txr-academy/FlashPod/README.md

# FlashPod
   
   ## Demo Video

https://github.com/user-attachments/assets/2fd0d5ae-2d88-44ac-92bb-8459e2031c8f
