txr-academy/FlashPod/flashpod_product_backlog.xlsx

Sheet: Product Backlog
Story ID | Epic | User Story / Task | Description | Priority | Story Points | Status | Sprint | Component | Acceptance Criteria
EPIC: Hardware Setup
HW-01 | Hardware Setup | Initialize WS2812B LED strip on nRF | Set up SPI1 peripheral on nRF52840 to drive WS2812B 16-pixel LED strip. Configure MOSI pin 17, SCK pin 31. Write rgb_led.c driver. | High | 5 | Done | 1 | nRF / LED | LED strip lights up correct colour when rgb_led_set_all() called
HW-02 | Hardware Setup | Initialize IR sensor on nRF (Pod 1) | Configure GPIO pin 13 as active-low input with pull-up for IR proximity sensor. Write ir_sensor.c driver. | High | 3 | Done | 1 | nRF / IR | ir_sensor_detected() returns true when hand is close
HW-03 | Hardware Setup | Initialize WS2812B LED strip on ESP32 | Use Adafruit NeoPixel library on GPIO pin 17 to drive 16-pixel strip on each ESP32 pod. | High | 3 | Done | 1 | ESP32 / LED | ledSetAll(r,g,b) lights all pixels in correct colour
HW-04 | Hardware Setup | Initialize IR sensor on ESP32 | Configure GPIO pin 13 as INPUT_PULLUP on ESP32. Read pin LOW as hand detected. | High | 2 | Done | 1 | ESP32 / IR | digitalRead(IR_PIN)==LOW triggers detection
HW-05 | Hardware Setup | Configure GPIO mode button on nRF | Connect push button to GPIO pin 24. Configure as active-low input with pull-up. Set up interrupt on falling edge. | Medium | 3 | Done | 2 | nRF / GPIO | button_pressed ISR fires on each button press
EPIC: BLE Communication
BLE-01 | BLE Communication | Set up NUS service on nRF (peripheral to phone) | Register Nordic UART Service. Implement received_from_phone callback for incoming commands. Implement notif_enabled_cb. | High | 5 | Done | 1 | nRF / BLE | Phone can connect and exchange text via nRF Connect app
BLE-02 | BLE Communication | Set up NUS service on ESP32 (peripheral to nRF) | Create BLE server with NUS service UUID. Implement RxCallbacks for commands from nRF. TX characteristic notifies nRF with results. | High | 5 | Done | 1 | ESP32 / BLE | nRF can write commands and receive notifications from ESP32
BLE-03 | BLE Communication | Implement BLE dual-role on nRF | nRF acts as peripheral to phone and central to ESP32 pods simultaneously. Tune scan interval (800ms/50ms window) so phone can connect during scan gaps. | High | 8 | Done | 1 | nRF / BLE | Phone connects while nRF scans for ESP32 pods without drops
BLE-04 | BLE Communication | Implement GATT discovery on nRF central | After connecting to each ESP32, discover all characteristics. Find and store RX handle and TX CCC handle for each pod. | High | 5 | Done | 1 | nRF / BLE | rx_handle and tx_ccc_handle populated after discovery
BLE-05 | BLE Communication | Subscribe to ESP32 notifications on nRF | After GATT discovery subscribe to TX characteristic notifications on each ESP32 pod. Implement pod_notify_cb to handle incoming results. | High | 5 | Done | 1 | nRF / BLE | pod_notify_cb fires when ESP32 sends RT or TIMEOUT
BLE-06 | BLE Communication | Implement write commands from nRF to ESP32 | Use bt_gatt_write_without_response to send ON:RRGGBB, OFF, and TIMEOUT:ms commands to ESP32 pods via RX characteristic handle. | High | 3 | Done | 1 | nRF / BLE | ESP32 LED turns on/off correctly on command
BLE-07 | BLE Communication | Auto-reconnect ESP32 pods on disconnect | Restart BLE scan when any ESP32 pod disconnects. Clear pod state and rediscover handles on reconnect. | Medium | 3 | Done | 2 | nRF / BLE | nRF reconnects to pod automatically after disconnect
BLE-08 | BLE Communication | Restart advertising after phone disconnect | Use adv_sem semaphore to restart BLE advertising from main thread when phone disconnects. | Medium | 2 | Done | 2 | nRF / BLE | Blazepod1 reappears in phone scan after disconnect
EPIC: Game Logic
GAME-01 | Game Logic | Implement IR polling thread on nRF (Pod 1) | Create dedicated Zephyr thread that polls IR sensor every 50ms. Calculate reaction time from LED on timestamp. Send RT or TIMEOUT to phone. | High | 5 | Done | 1 | nRF / RTOS | POD1:RT:xxx sent correctly within 50ms of hand detection
GAME-02 | Game Logic | Implement IR polling task on ESP32 | FreeRTOS task polls IR every 50ms. On detection sends PODx:RT:ms notification. On timeout sends PODx:TIMEOUT. | High | 5 | Done | 1 | ESP32 / RTOS | ESP32 sends correct RT and TIMEOUT messages to nRF
GAME-03 | Game Logic | Implement Game Mode 1 — single random pod | Game thread picks random pod (0-3) and random colour from colour table. Lights up selected pod. Waits for IR detection or timeout. | High | 8 | Done | 2 | nRF / Game | Random pod lights up each round, RT reported to phone
GAME-04 | Game Logic | Implement Game Mode 2 — odd one out | All 4 pods light up simultaneously. 3 pods get majority colour, 1 pod gets different colour. Odd pod chosen randomly. nRF determines correct/wrong based on odd_pod_index. | High | 13 | Done | 3 | nRF / Game | Correct tap sends RT, wrong tap sends WRONG to phone
GAME-05 | Game Logic | Implement correct/wrong detection in Mode 2 | pod_notify_cb and IR thread check tapped pod index against odd_pod_index. Send RT if correct, WRONG and turn off all pods if wrong. | High | 5 | Done | 3 | nRF / Game | WRONG sent immediately on wrong pod tap, round ends
GAME-06 | Game Logic | Implement round management with semaphores | Use round_done_sem to signal round end from IR thread or pod_notify_cb to game thread. Use round_ended flag to prevent duplicate signals. | High | 5 | Done | 2 | nRF / RTOS | Only one result sent per round regardless of timing
GAME-07 | Game Logic | Implement start/stop game commands from phone | Mode 1: phone sends colour command (RED/GREEN etc) to start. Mode 2: phone sends START. Both modes: STOP command ends game cleanly. | High | 3 | Done | 2 | nRF / BLE | Game starts and stops correctly from phone commands
GAME-08 | Game Logic | Fix BLE disconnect on IR detection | IR thread stack overflow caused disconnect when calling bt_nus_send. Fixed by increasing IR thread stack from 512 to 2048 bytes. | High | 3 | Done | 2 | nRF / RTOS | No BLE disconnect when IR detects hand
EPIC: UX & Control
UX-01 | UX & Control | Implement GPIO mode switch button | Push button on GPIO pin 24. ISR toggles between GAME_MODE_1 and GAME_MODE_2. No mutex in ISR — direct variable access. | Medium | 5 | Done | 2 | nRF / GPIO | Mode toggles on each button press, confirmed in serial log
UX-02 | UX & Control | Allow mid-game mode switching | Button press during game: turns off all pods, sets round_ended, signals round_done_sem and game_start_sem so game thread restarts in new mode immediately. | Medium | 5 | Done | 3 | nRF / Game | Mode changes take effect within one round after button press
UX-03 | UX & Control | Send game results to phone in real time | All RT, WRONG, TIMEOUT results sent to phone via bt_nus_send. Phone sees results in nRF Connect UART terminal. | High | 3 | Done | 1 | nRF / BLE | Phone displays PODx:RT:ms after each correct tap
UX-04 | UX & Control | Notify phone of mode and round info | Send MODE2:ODD_POD=x MAJ=colour ODD=colour before each Mode 2 round so phone knows expected answer. Send MODE2:ALL_ON when pods light up. | Low | 2 | Done | 3 | nRF / BLE | Phone receives round info message before each Mode 2 round
EPIC: Integration
INT-01 | Integration | Fix simultaneous scan and advertise conflict | nRF could not accept phone connections while scanning. Fixed by reducing scan window to 50ms with 800ms interval to create advertising gaps. | High | 5 | Done | 2 | nRF / BLE | Phone connects reliably while nRF scans for ESP32 pods
INT-02 | Integration | Validate full Mode 1 end-to-end flow | Phone sends RED → nRF picks random pod → pod lights up red → user taps → RT sent to phone. Test all 4 pods and all 6 colours. | High | 5 | Done | 3 | System | All pods report correct RT in Mode 1 for all colours
INT-03 | Integration | Validate full Mode 2 end-to-end flow | Phone sends START → all 4 pods light up with one odd colour → correct tap sends RT → wrong tap sends WRONG → no tap sends TIMEOUT. | High | 8 | Done | 3 | System | Correct/wrong/timeout all reported correctly in Mode 2
INT-04 | Integration | Test mode switch mid-game | Press button during Mode 1 round → current round ends immediately → Mode 2 starts. Press during Mode 2 → switches back to Mode 1. | Medium | 3 | Done | 3 | System | Mode switches within one round, no stuck states

Sheet: Summary
Epic | Total Stories | Total Story Points | Status
Hardware Setup | 5 | 16 | Done
BLE Communication | 8 | 36 | Done
Game Logic | 8 | 47 | Done
Persistence | 4 | 14 | Done
UX & Control | 4 | 15 | Done
Integration | 4 | 21 | Done
TOTAL | 33 | 149
