txr-academy/FlashPod/flash_pod_build_steps.docx

## How to Build and Deploy Code for nRF52840 Dongle

### Step 1: Clone the Project

1. Open Command Prompt (CMD).
2. Navigate to the folder where you want to save the project.

cd C:\Users\TXR\Desktop\flash_pod

3. Clone the GitHub repository.

git clone https://github.com/txr-academy/FlashPod

After cloning, the project structure will look like:

FlashPod/

├── esp32code/

├── nrf52840code/

├── README.md

### Step 2: Prepare the nRF52840 Project

1. Open Visual Studio Code.
2. Go to File → Open Folder.
3. Open the nrf52840code folder.

#### Create the Required Folder Structure

Create a folder named boards and move the overlay file into it.

boards/

└── nrf52840dongle_nrf52840.overlay

Create another folder named src and move all source and header files into it.

src/

├── main.c

├── rgb_led.c

├── rgb_led.h

├── buzzer.c

├── buzzer.h

├── ir_sensor.c

└── ir_sensor.h

The final project structure should be:

nrf52840code/

├── boards/

│ └── nrf52840dongle_nrf52840.overlay

├── src/

│ ├── main.c

│ ├── rgb_led.c

│ ├── rgb_led.h

│ ├── buzzer.c

│ ├── buzzer.h

│ ├── ir_sensor.c

│ └── ir_sensor.h

├── CMakeLists.txt

└── prj.conf

### Step 3: Build the Project in VS Code

1. Open the nRF Connect extension in VS Code.
2. Click Applications.
3. Select Add Build Configuration.
4. Configure the build with the following settings:
  - Board Target: nrf52840dongle/nrf52840
  - Build Directory: Default
  - Configuration: Default (prj.conf)
5. Click Generate and Build.

After a successful build, the output files will be generated in the build directory, including:

build/

└── zephyr/

├── zephyr.hex

└── merged.hex

The merged.hex file is used for programming the nRF52840 Dongle.

### Step 4: Flash the Firmware

1. Connect the nRF52840 Dongle to your PC.
2. Open nRF Connect for Desktop.
3. Launch the Programmer application.
4. Select the connected nRF52840 Dongle.
5. Click Add File and browse to:

build\zephyr\merged.hex

6. Click Write (or Erase & Write) to program the firmware.

Once flashing is complete, the firmware will start running on the nRF52840 Dongle.
