txr-academy/FlashPod/(commit log)

2026-04-07 Added product backlog and architecture PDF
    [Product Backlog_template.xlsx]
2026-05-24 new changes and code
    [Product Backlog_template.xlsx, flashpod_product_backlog.xlsx]
2026-06-10 esp32 code
    new changes
2026-07-02 ir changed from polling to interrupt
2026-08-05 esp32 code updation
2026-09-22 Add README for BLE LED Matrix Scoreboard project
    Added README.md for BLE LED Matrix Scoreboard project, detailing project overview, key features, components, libraries, connection overview, usage instructions, and command glossary.
